pacodey/vishwakarma-2026-haptic-posture-device/photos/makerjourney kicad.png

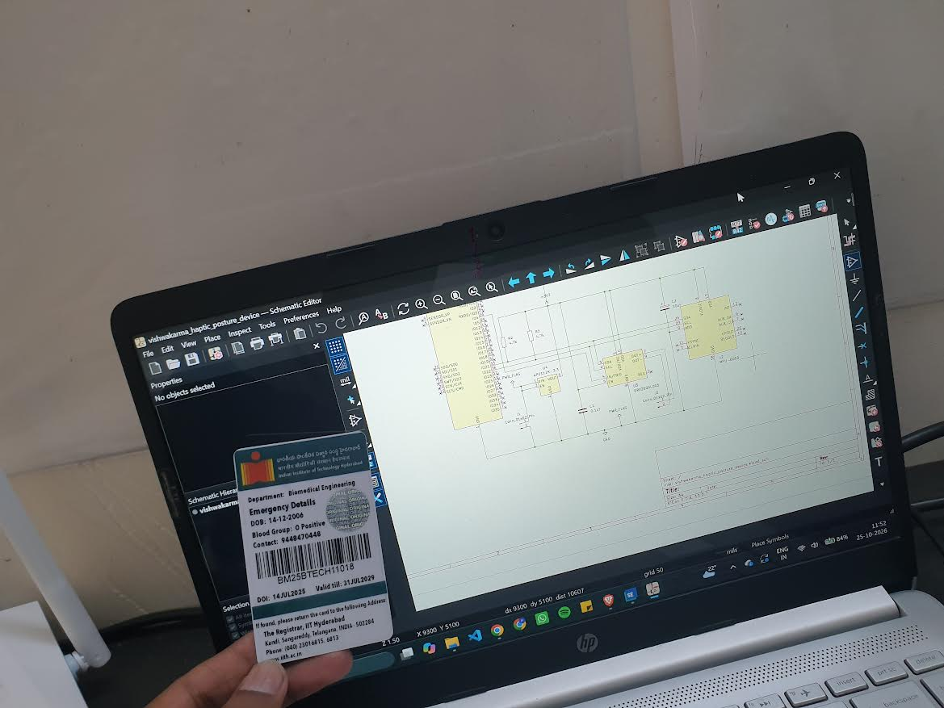
photos/makerjourney kicad.png
