pacodey/vishwakarma-2026-haptic-posture-device/photos/makerjourney materials.jpg

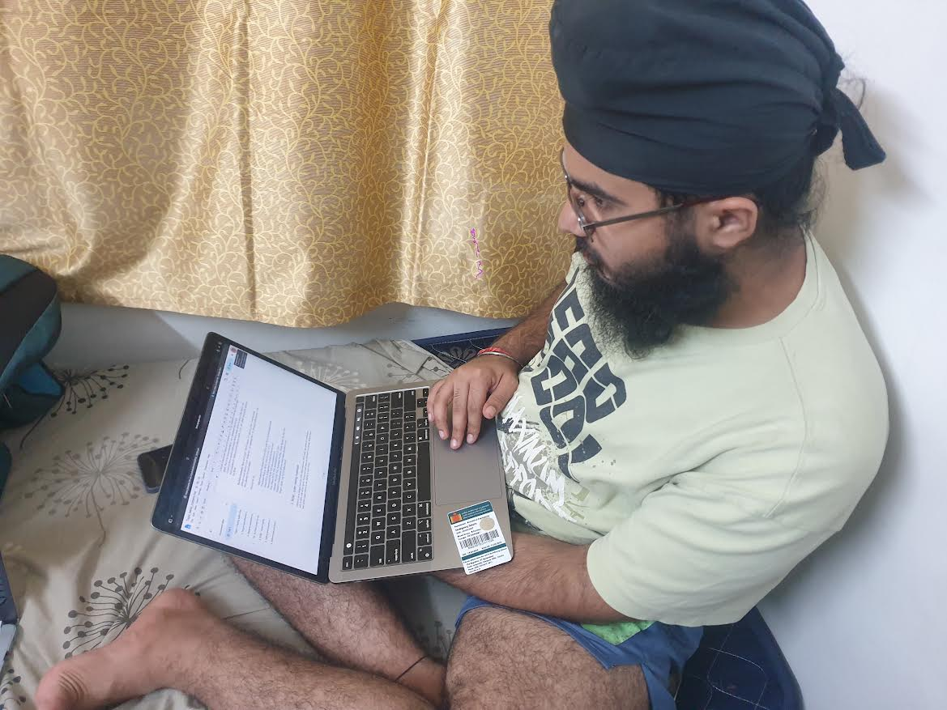
photos/makerjourney materials.jpg
