pacodey/vishwakarma-2026-haptic-posture-device/README.md

# Closed-Loop Haptic Posture Corrector (Posture Pod)

## Project Overview
An ergonomic, sternum-mounted wearable device designed for real-time posture monitoring and active haptic entrainment. Utilizing an ESP32-WROOM-32 MCU and an MPU-6050 6-axis IMU, the system detects thoracic flexion/extension deviations and triggers discrete, frequency-tuned haptic cues via a TI DRV2605L driver and ERM coin motor.
