pacodey/vishwakarma-2026-haptic-posture-device/hardware/README.md

# Electronics Hardware & EDA Files

This folder contains the complete circuit schematics, board layouts, and procurement documentations for the Posture Pod carrier board, built using **KiCad 10.0**.
