pacodey/vishwakarma-2026-haptic-posture-device/CAD/README.md

# Mechanical Design & CAD Assets

This folder contains all parametric 3D CAD assets for the Posture Pod sternum enclosure and internal component stack, developed in **Solid Edge 2026**.
