pacodey/vishwakarma-2026-haptic-posture-device/hardware/posture_respiratory_haptic_block_diagram.pdf

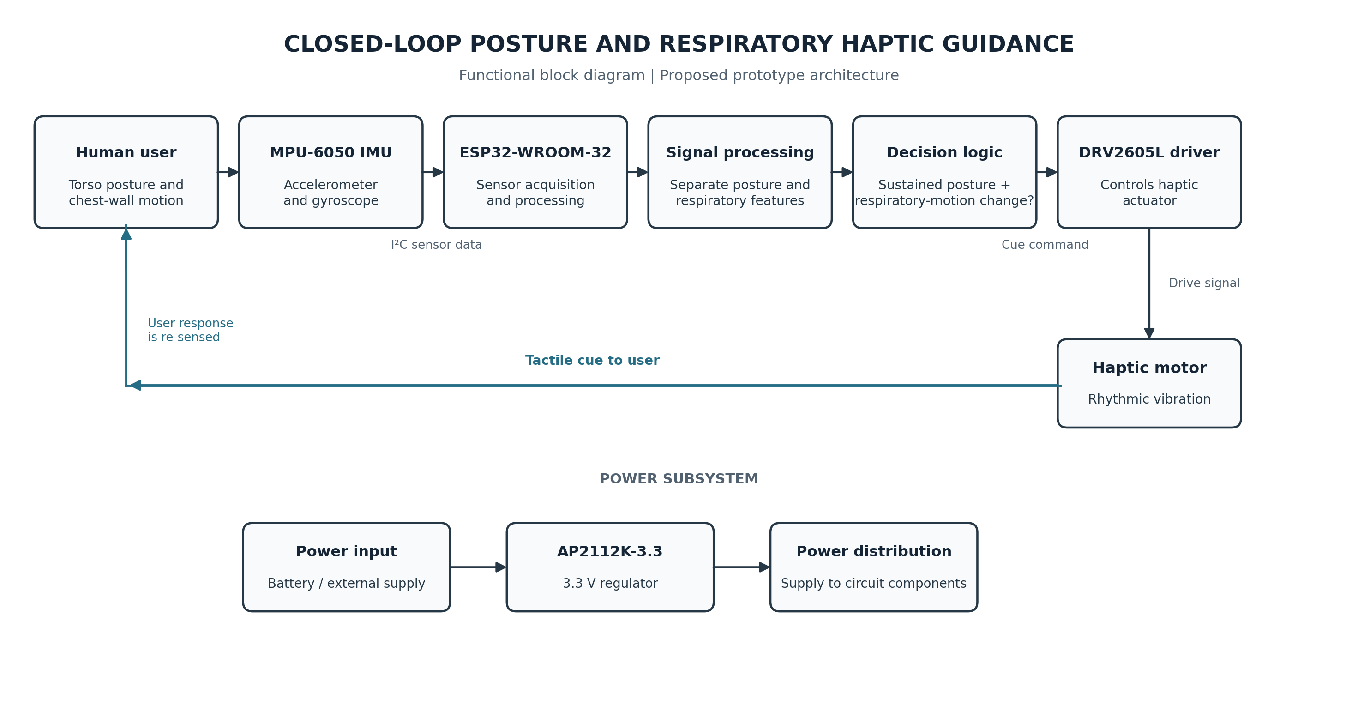
[picture p3: page 1]
