pacodey/vishwakarma-2026-haptic-posture-device/CAD/Exploded_View_Labelled.png

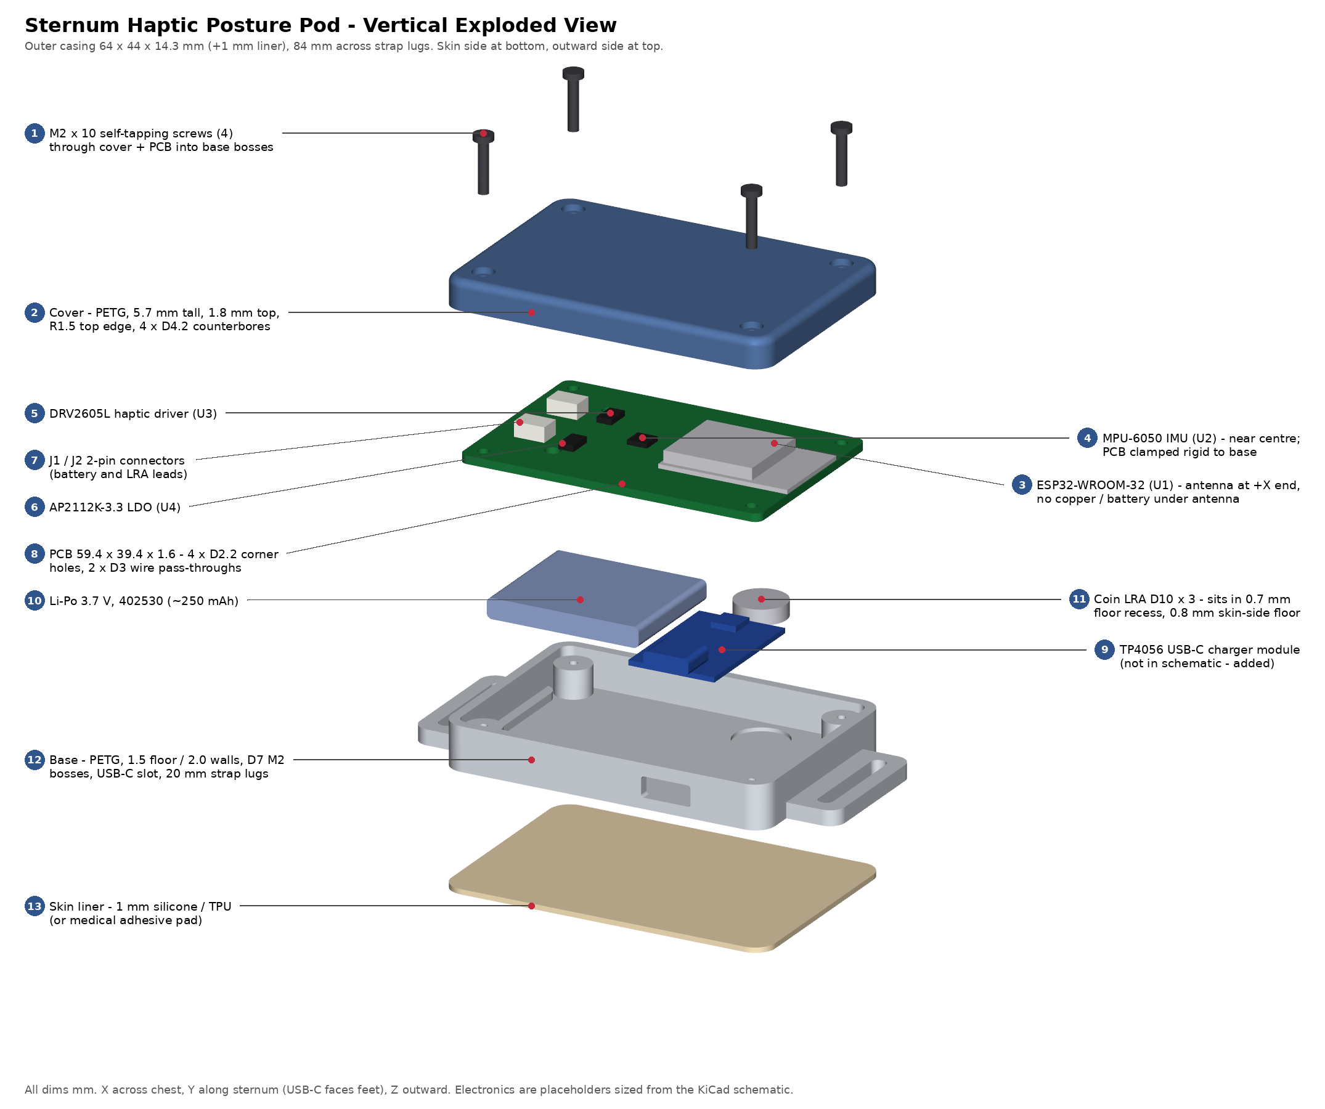
CAD/Exploded_View_Labelled.png
