pacodey/vishwakarma-2026-haptic-posture-device/photos/image.png

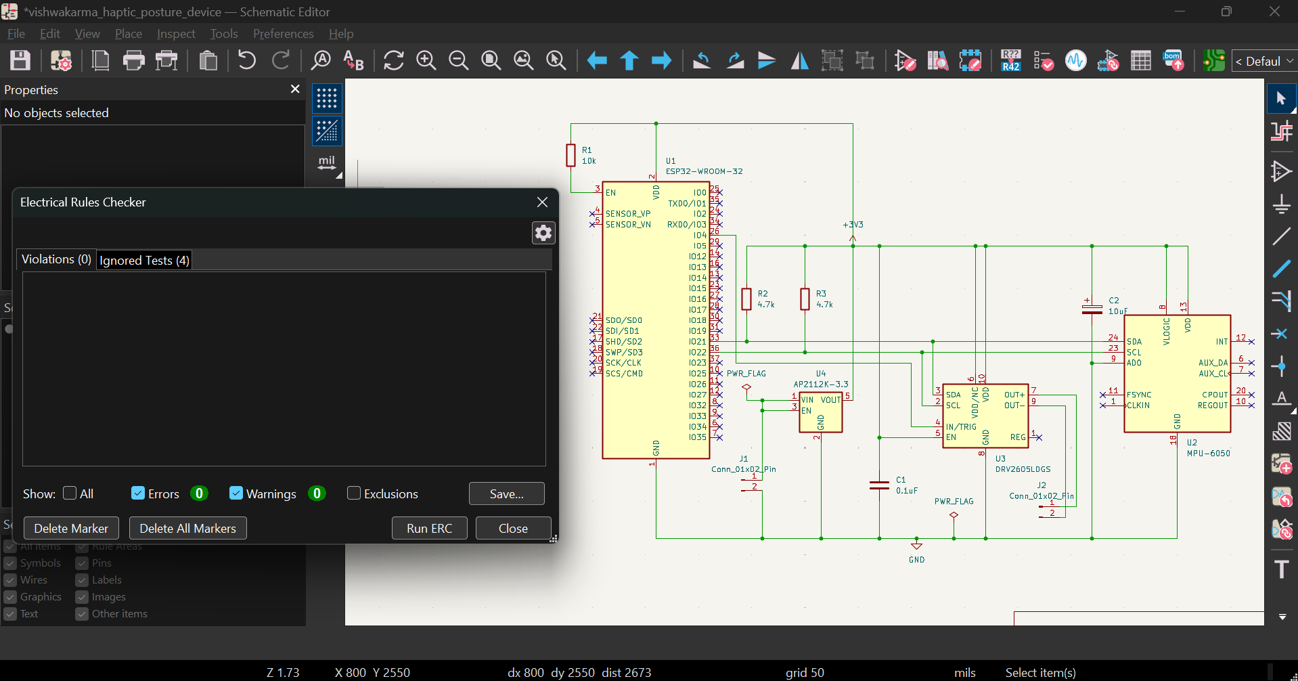
photos/image.png
