pacodey/vishwakarma-2026-haptic-posture-device/photos/kicad schematic.png

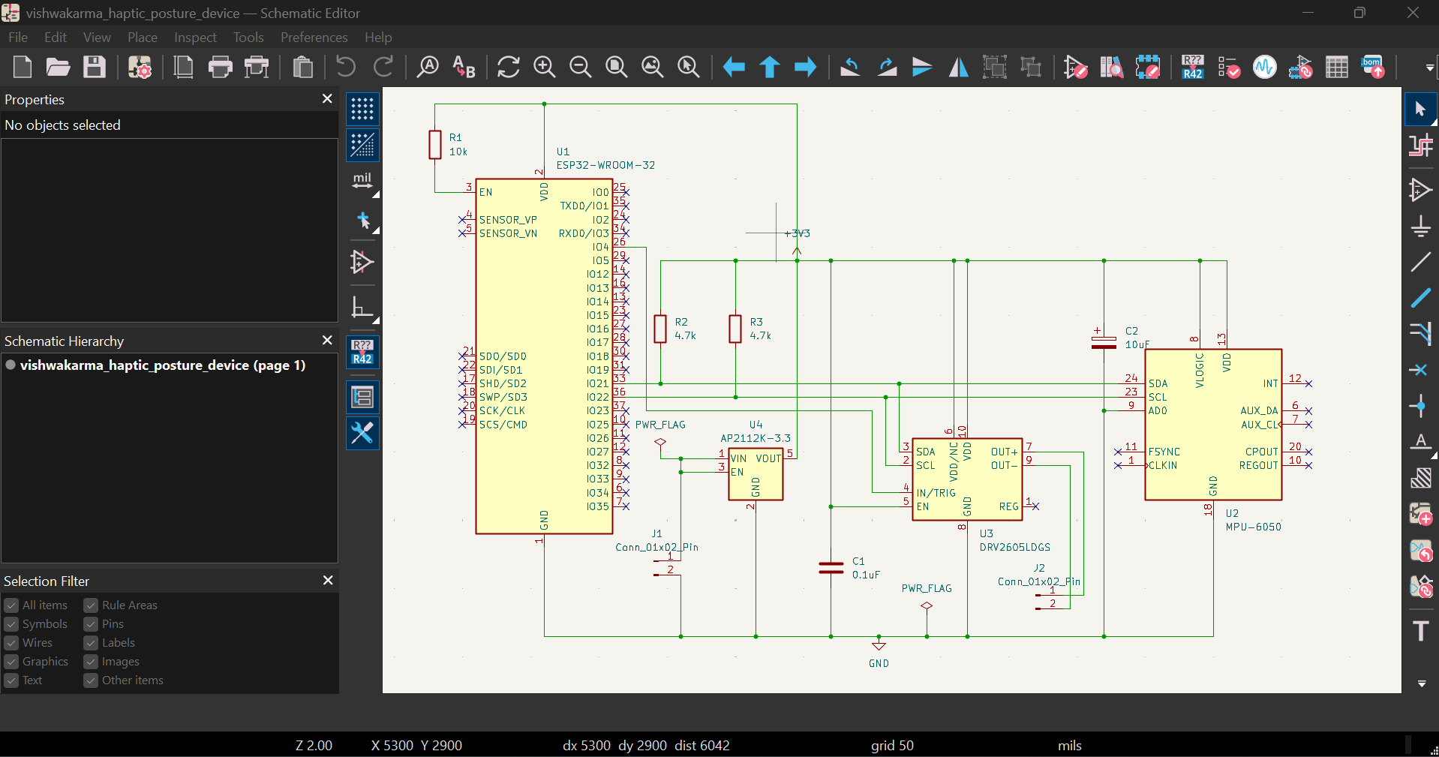
photos/kicad schematic.png
