pacodey/vishwakarma-2026-haptic-posture-device/photos/part2_cover_ss.jpg

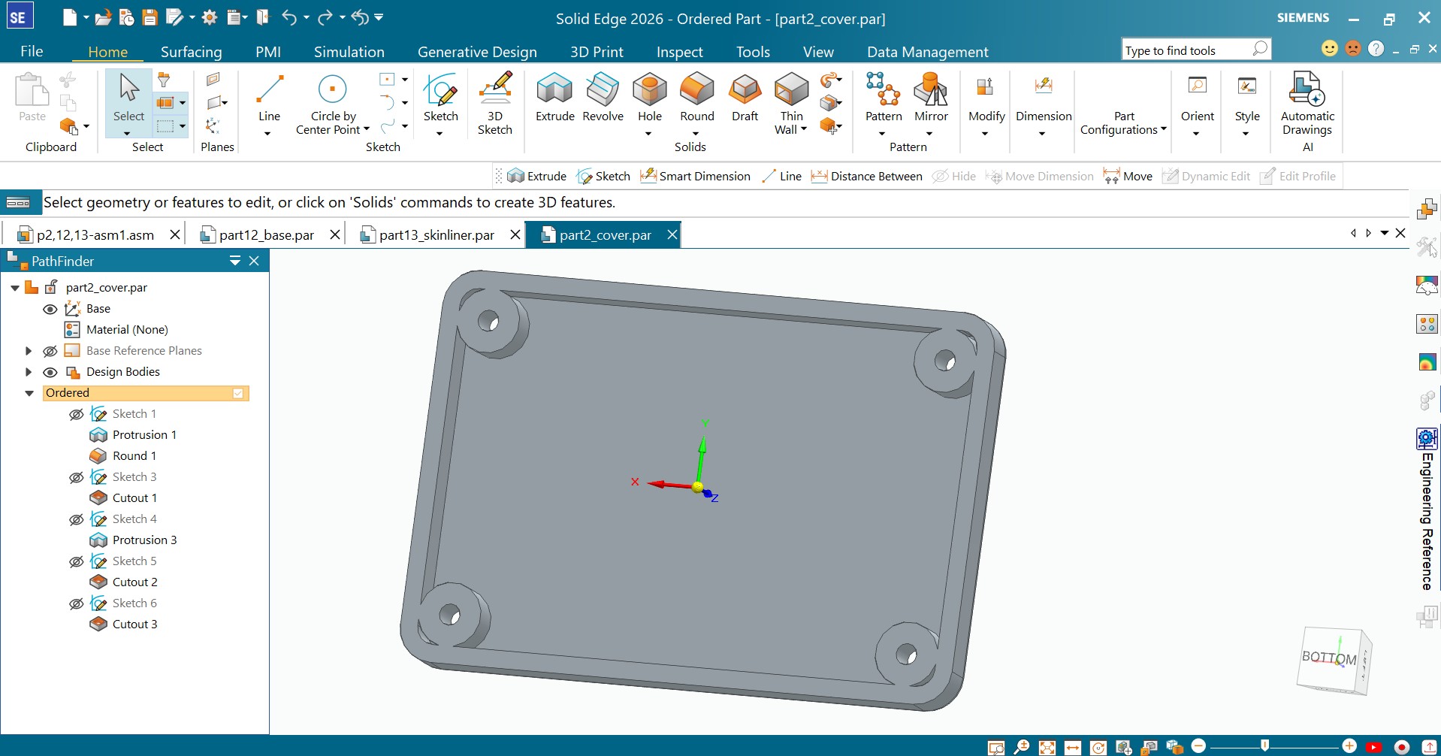
photos/part2_cover_ss.jpg
