pacodey/vishwakarma-2026-haptic-posture-device/photos/part12_base_ss.jpg

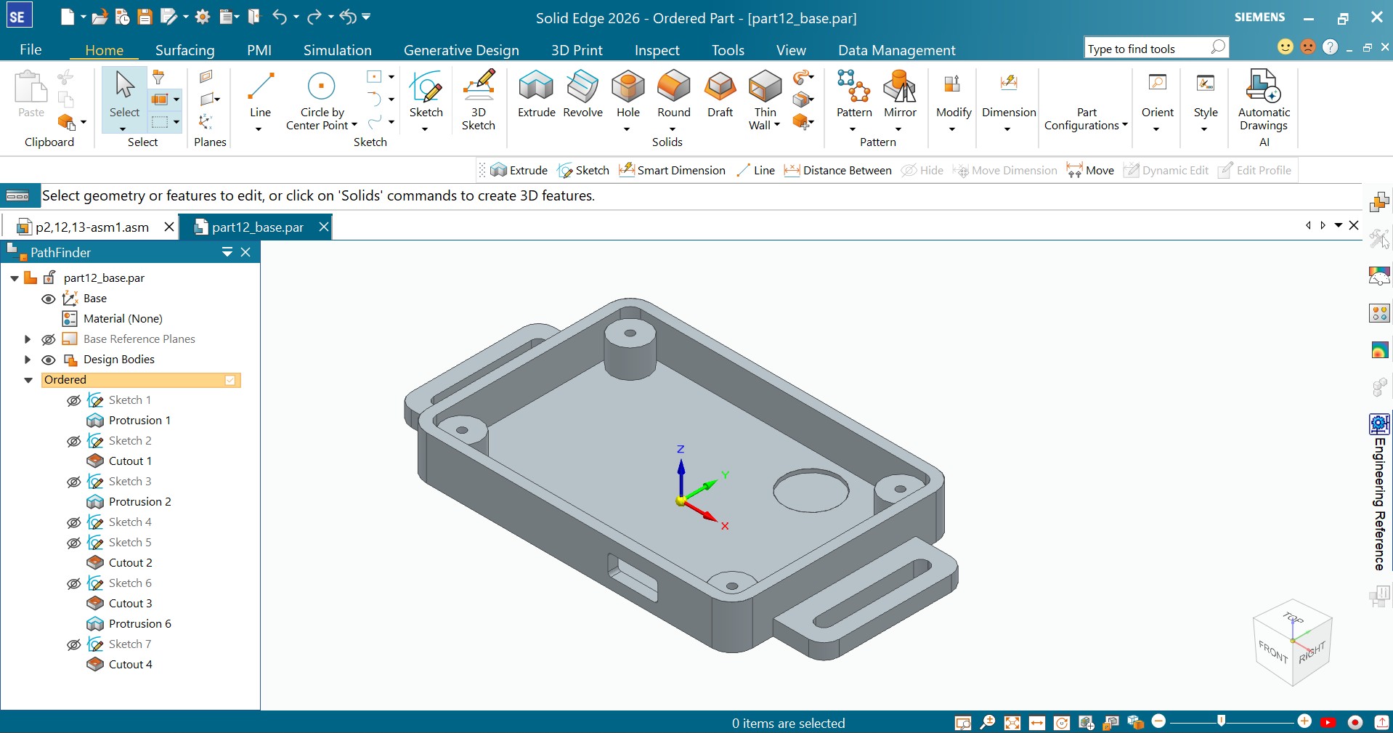
photos/part12_base_ss.jpg
