pacodey/vishwakarma-2026-haptic-posture-device/photos/part13_skinliner_ss.jpg

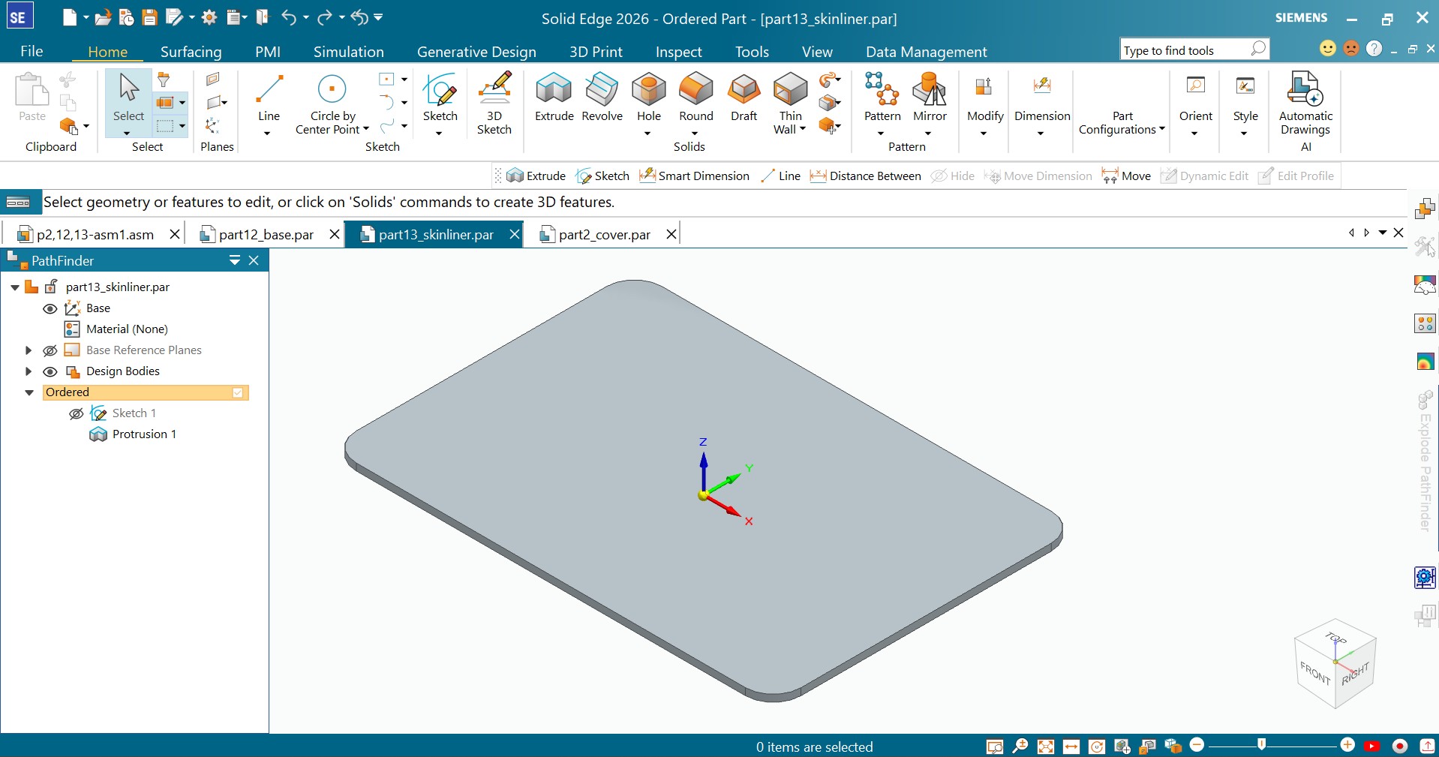
photos/part13_skinliner_ss.jpg
