pacodey/vishwakarma-2026-haptic-posture-device/haptic posture device materials.docx

# Tisjot - Casing tasks (Sternum Haptic Posture Pod)

## 1. Target specification (power, vibration, mechanical)

Parameter | Target | Basis
Outer size | 64 x 44 x 14.3 mm; 15.3 mm with 1 mm liner; 84 mm over strap lugs | Reconstruction sheets, checked on the STEP
Strap | 20 mm webbing through 3 x 22 mm slots | Sheet, Part 12
Pod mass (est.) | about 38 g: casing about 23.6 g (solid PETG + liner), electronics about 14 g | Computed from CAD volumes; the electronics figure is an estimate. Weigh the real build.
Supply | 3.7 V LiPo 402530, about 250 mAh, regulated to 3.3 V (AP2112K-3.3, 600 mA) | Schematic and BOM
Average current for 8 h wear | at most 25 mA (250 mAh x 80% usable / 8 h) | Calculation
Current at about 40 mA average | about 5 h runtime | Calculation
Haptic drive | Drive the LRA at its own resonance. Coin LRAs of this size are typically around 170-240 Hz [verify on your exact part]. | DRV2605L has auto-resonance tracking
Vibration strength | Clearly felt through a shirt on the sternum. Target at least 1 g on the pod, to be confirmed by bench test with a phone accelerometer or the MPU-6050. | Target only, not measured
Charging current | at most 1C = 250 mA (see the safety item on Rprog) | TP4056 datasheet: I = 1200 / Rprog
Skin-side surface temperature | at most 41 degC during charge and use | Conservative target for prolonged skin contact [verify against IEC 62368-1 / IEC 60601-1 limits]
Ingress | No IP claim. Make it IP22 "splash/sweat resistant" only after adding a gasket and testing. | The USB-C slot and the cover seam are unsealed today

Design note: the ESP32-WROOM-32 draws far more than a 25 mA average if Wi-Fi is on. Use BLE only with light sleep, and sample the IMU at 25-50 Hz. Ask Parth to confirm this in firmware.

## 2. Material selection (outer casing)

Part | Chosen | Why | Alternatives considered
Base (12) and Cover (2) | PETG, 3D printed, 4 perimeters | Tough, slightly flexible, so it does not crack at the screw bosses. Easy to print, no supports. Moisture and sweat resistant. Glass transition about 80 degC (verified on several filament datasheets, see section 2A), well above skin and charging temperatures. | PLA: brittle and softens in a hot car. ABS/ASA: fumes and warping, no benefit at this size. Nylon: absorbs moisture. PC: hard to print.
Skin liner (13) | Medical-grade platinum-cured silicone sheet, 1 mm, ISO 10993 / USP Class VI (do not use printed TPU on skin, see 2A) | Soft, grippy and non-irritating. It keeps skin off the printed PETG layer lines. | Direct PETG on skin: layer lines hold sweat and bacteria, and the surface is hard.
Fasteners (1) | 4 x M2 x 10, A2 stainless, button/pan head (ISO 7380 style) | The counterbore is sized for a head 1.1 mm tall. Thread-forming into D1.6 pilots. | Heat-set inserts: better for repeated opening, but more cost and process.
Adhesives | Silicone adhesive or double-sided medical tape (liner); foam tape (LiPo, TP4056) | From the sheet's assembly order | -

Mechanical risk to mention on the slide: the cover top is 1.8 mm and the counterbore is 1.2 mm deep, so only 0.6 mm of PETG sits under each screw head. That is fine for a light-clamp load. If a cover cracks during printing or assembly, make the counterbore 0.8 mm deep (leaving 1.0 mm) and use a lower-head screw.

## 2A. Verified material data

PETG (base and cover)

Property | Verified value | Source datasheet
Density | 1.25-1.29 g/cm3; 1.27 used (matches Fillamentum, Push Plastic, MatterHackers PRO, Kimya 1.274) | ISO 1183 / ASTM D792 values
Glass transition | 80-81 degC | Polymaker PolyLite PETG, Kimya PETG-S, MatterHackers
Heat deflection / Vicat | HDT 0.45 MPa about 75-78 degC; Vicat 84 degC | Polymaker, MatterHackers ESD PETG
Tensile strength, printed XY | 32-47 MPa depending on brand (Polymaker 31.9, Kimya 46.6) | Printed 100% infill specimens
Tensile strength, across layers (Z) | only about 13 MPa | Polymaker PolyLite PETG (Conrad copy)
Water absorption | 0.12-0.54% depending on test | 3D4MAKERS, Polymaker
Compliance claims (vendor claims, not tests you ran) | Kimya PETG-S: RoHS and REACH; food-contact certified in natural colour only. Fillamentum: no restricted substances. | Kimya, Fillamentum datasheets

What this changes in your design:

- Use a conservative 30 MPa for printed PETG in any slide calculation, not the 50 MPa on the spool box.
- Layer adhesion across Z is weak (about 13 MPa). Printing skin-face down keeps the lugs and bosses loaded along the layers, which is what the sheet's print note already does.
- A body-temperature part sits far below 80 degC, so heat is not a PETG problem.
- If you want a filament with a paper trail for the slide, choose one that publishes a RoHS/REACH statement (for example Kimya PETG-S or Fillamentum PETG) and cite that datasheet. Natural/clear colour only for the food-contact claim, which you do not need anyway.

Skin liner: silicone, not TPU

- The Ultimaker TPU 95A datasheet lists in-vivo and food-contact applications as "not suitable". Printed TPU (density 1.20-1.24 g/cm3, Shore 95A) is therefore fine for a prototype liner, but it is not the right material to claim as skin-safe.
- Medical-grade silicone sheet suppliers (for example ElastaPro) state platinum-cured sheet meets USP Class VI and ISO 10993 (cytotoxicity -5, sensitization and irritation -10) and is made for wearables with long skin exposure. These are supplier claims, so ask for the certificate with your quote.
- Choose a soft sheet (about 40-50 Shore A) in 1.0 mm. ElastaPro lists 30-70 durometer sheet. This is my recommendation, not a datasheet requirement.
- I could not find a verified India-based silicone sheet vendor or price in this search. Ask local suppliers for "platinum-cured silicone sheet, 1 mm, ISO 10993" and put the quote in the BOM.

Decision summary: Base and cover = PETG (about 1.27 g/cm3). Liner = medical-grade platinum-cured silicone 1 mm. Fasteners = A2 stainless M2 x 10. Prototype fallback liner = TPU 95A, labelled "not skin-rated".

Sources for 2A:

- MatterHackers PRO Series PETG and ESD-Safe PETG technical data sheets
- Polymaker PolyLite PETG TDS (V3.0 and V4.0)
- Kimya PETG-S datasheet (via shop3duniverse.com)
- Fillamentum PETG TDS (via polyalkemi.no)
- Push Plastic PETG TDS; 3D4MAKERS PETG TDS
- Ultimaker TPU 95A TDS; Polymaker PolyFlex TPU95; Bambu TPU 95A TDS
- ElastaPro medical-grade silicone sheet pages (elastapro.com)
- Moglix, eSUN 1 kg PETG listing (price)

## 3. BOM - outer casing materials

Volumes come straight from the CAD. Mass assumes 100% solid; real prints at 4 perimeters and 20-40% infill will be lighter. Prices and lead times are left blank on purpose: fill them from real vendor pages

# | Part | Material | Qty | Volume (cm3) | Mass (g, solid) | Make/Buy | Supplier / lead time / INR

12 | Base | PETG | 1 | 9.03 | 11.5 | Make (print) | Filament: eSUN PETG 1 kg, Rs 1,744 incl. GST on Moglix at time of search (listed 'available on request'). About Rs 36 of filament for both PETG parts.
2 | Cover | PETG | 1 | 6.98 | 8.9 | Make (print) | ___
13 | Skin liner | Medical-grade silicone sheet, 1 mm | 1 | 2.80 | 3.2 | Buy sheet, cut to 64 x 44 R4 | ___ (ask supplier for ISO 10993 / USP Class VI certificate)
1 | M2 x 10 screw | A2 stainless | 4 | - | about 0.3 total | Buy | ___
- | Medical tape / silicone adhesive | - | 1 | - | - | Buy | ___
- | Foam tape (LiPo and TP4056) | - | 1 | - | - | Buy | ___
- | Strap, 20 mm webbing | Nylon or elastic | 1 | - | - | Buy | ___

Filament: about 20.4 g of PETG solid, plus the liner. 20.4 g / 1000 g x Rs 1,744 = about Rs 36.

## 4. Safety and hazard mitigation (casing + electronics)

# | Hazard | Cause | Mitigation

1 | LiPo overcharge or overheating, fire | Standard TP4056 modules ship with Rprog = 1.2 kohm, which charges at 1 A. That is 4C for a 250 mAh cell. | Change Rprog to 4.7-5.1 kohm (about 255-235 mA). Use a cell with its own protection circuit (PCM). Prefer a TP4056 module that includes DW01 + FS8205 protection.
2 | Burns or discomfort on skin | Hot cell or regulator against the chest | Surface limit of 41 degC (see spec); 1 mm liner; test charging while powered.
3 | Shock or heat while charging on the body | USB-C cable plugged in while worn | Instruction: do not wear while charging. Ask Parth about wiring the charger STAT pin to an ESP32 GPIO so firmware can block haptics during charge. It is not in the current schematic.
4 | Skin irritation or allergy | Hard printed plastic, adhesive, nickel in screws | Silicone liner. Medical tape rated for skin. Do not let the screws touch skin (they are on the outward side, under the cover).
5 | Sweat or moisture ingress | USB-C slot (9.8 x 4.0 mm) and cover seam are open | No IP claim. Add a thin silicone gasket in a later revision. Tell users to keep the slot dry.
6 | Strap lug or boss fracture | Thin 0.6 mm counterbore floor; lug bars about 3 mm wide | Print at 4 perimeters. Strap pull is a few newtons at most. If you have time, a hand-calc or quick FEA on the lug is a good slide.
7 | Radio performance loss | Body tissue and LiPo near the ESP32 antenna | The CAD keeps the antenna at the +X end with no copper or battery under it. Test BLE range on the body.
8 | Vibration annoys or wakes the user | LRA too strong | Software amplitude levels. DRV2605L has built-in effect libraries.

Standards table (apply the "global regulation" line from your task list):

Area | Standard / rule | Applies to
Skin-contact materials | ISO 10993-1 (biological evaluation); -5 cytotoxicity, -10 irritation and sensitization | Liner and any adhesive. Printed PETG is not certified: use filament supplier data, and keep the liner between PETG and skin.
Battery | IEC 62133-2 (cell safety); UN 38.3 (transport); IS 16046 (Part 2) in India [verify] | LiPo cell. Request test reports from the seller.
Product safety | IEC 62368-1 (electronic equipment) | Whole pod
Radio | Module FCC/CE approvals from Espressif; India WPC equipment type approval (ETA) for 2.4 GHz devices [verify] | ESP32-WROOM-32
Hazardous substances | RoHS (EU 2011/65/EU) and India E-Waste (Management) Rules 2022 | Electronics and screws
Positioning | A wellness / posture-coaching device, not a diagnostic or treatment device. If it claimed to treat or diagnose, medical-device rules would apply (India CDSCO Medical Devices Rules 2017; FDA general wellness policy as a reference) [verify]. | Keep all slide wording on "reminder / coaching".

## 5. References and sources

Datasheets

1. Espressif, ESP32-WROOM-32 datasheet.
2. Texas Instruments, DRV2605L datasheet (haptic driver, SLOS854).
3. InvenSense / TDK, MPU-6050 datasheet.
4. Diodes Inc., AP2112 3.3 V LDO datasheet.
5. NanJing Top Power, TP4056 datasheet (charge current = 1200 / Rprog).

Standards and rules 6. ISO 10993-1:2018, Biological evaluation of medical devices. 7. IEC 62133-2:2017, Safety requirements for portable sealed secondary lithium cells. 8. UN Manual of Tests and Criteria, Section 38.3 (lithium battery transport). 9. IEC 62368-1, Audio/video, information and communication technology equipment safety. 10. Directive 2011/65/EU (RoHS); India E-Waste (Management) Rules, 2022. 11. ISO 7380-1 (button head screws). 12. India Medical Devices Rules, 2017 (CDSCO); FDA General Wellness guidance.
