pacodey/vishwakarma-2026-haptic-posture-device/hardware/haptic posture device electronics BOM.pdf

# Itemized Electronics Bill of Materials (BOM)

### Closed-Loop Haptic Posture Corrector (Posture Pod)

ELECTRONICS & SUBSYSTEM BOM

ITEM

COMPONENT
DESCRIPTION

PART NUMBER /
SPECIFICATION

QTY SOURCE / VENDOR

LEAD
TIME

UNIT
COST (₹)

TOTAL (₹)

E1

Microcontroller
Module

ESP32-WROOM-32 (Dual-Core 240MHz)

1 Robu.in / Domestic

2-3
Days
350.00 | 350.00

E2

6-Axis IMU Motion
Sensor

TDK InvenSense MPU-6050 (I2C)

1 | Robu.in / Domestic | 2 Days | 180.00 | 180.00
E3 | Haptic Driver IC

TI DRV2605LDGS (VSSOP-10)

1 | ElectronicsComp | 3 Days | 220.00 | 220.00

E4

Eccentric Mass
Motor

1027 ERM Coin Vibration
Motor (3V)
1 | Local Sourcing | 1 Day | 30.00 | 30.00

E5

Low Dropout
Regulator

AP2112K-3.3V LDO (SOT-23-5)

1 | Robu.in / Domestic | 2 Days | 25.00 | 25.00

E6

Rechargeable
Power Cell

3.7V 500mAh LiPo Cell +
JST-PH2.0
1 | Robu.in / Domestic | 2 Days | 210.00 | 210.00

E7

Battery Charger
Module

TP4056 USB-C Protection
Board
1 | Local Sourcing | 1 Day | 35.00 | 35.00

E8

Passive
Components Set

0805 SMD Resistors,
Caps, J1 Switch

1
Set
Local Sourcing | 1 Day | 32.00 | 32.00
E9 | Custom Carrier PCB

FR4 2-Layer 1.6mm 1oz
Cu (JLCPCB)

1

JLCPCB Domestic
Batch
5 Days | 300.00 | 300.00
TOTAL ELECTRONICS BOM COST: | ₹1,382.00
Closed-Loop Haptic Posture Corrector — Electronics BOM | Page 1 of 1
