pacodey/vishwakarma-2026-haptic-posture-device/CAD/p2,12,13-asm1.stp

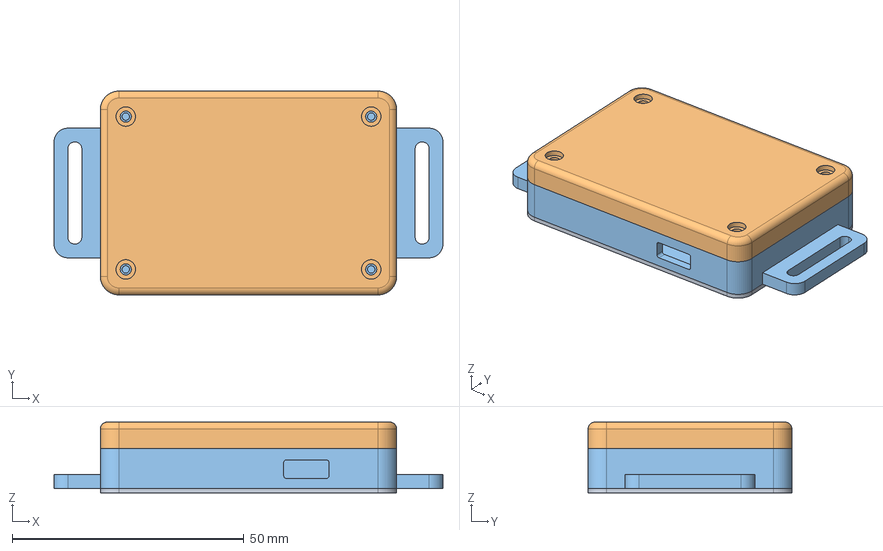
[picture p10: CAD file, 2026-10-25]
CAD/p2,12,13-asm1.stp
84.0 x 44.0 x 15.3 mm
part13_skinliner
part2_cover
part12_base
