pacodey/vishwakarma-2026-haptic-posture-device/CAD/part13_skinliner.stp

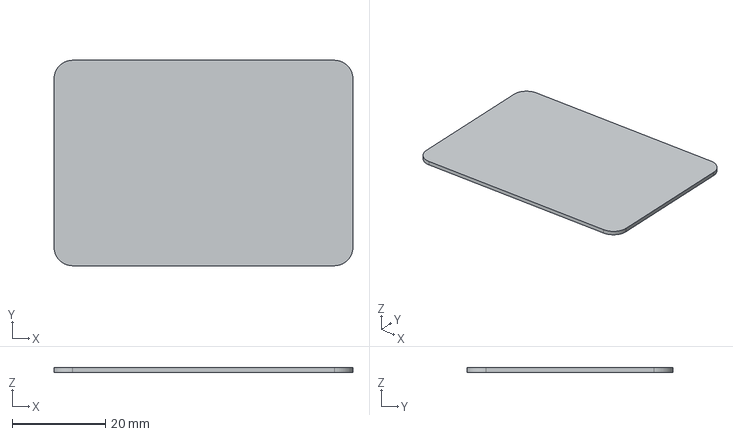
[picture p11: CAD file, 2026-10-25]
CAD/part13_skinliner.stp
64.0 x 44.0 x 1.00 mm
