pacodey/vishwakarma-2026-haptic-posture-device/CAD/part2_cover.stp

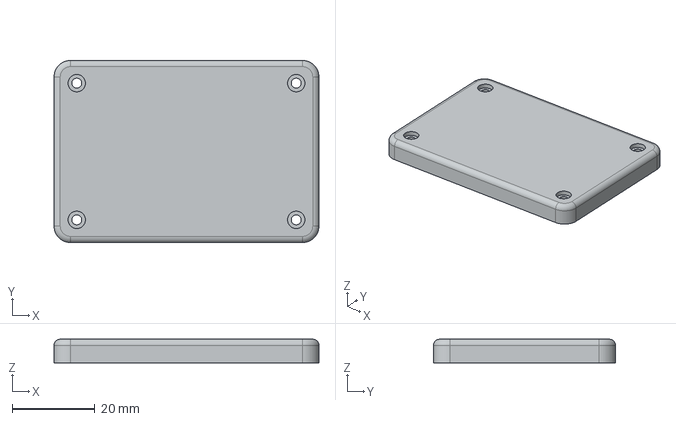
[picture p12: CAD file, 2026-10-25]
CAD/part2_cover.stp
64.0 x 44.0 x 5.70 mm
