pacodey/vishwakarma-2026-haptic-posture-device/CAD/part12_base.stp

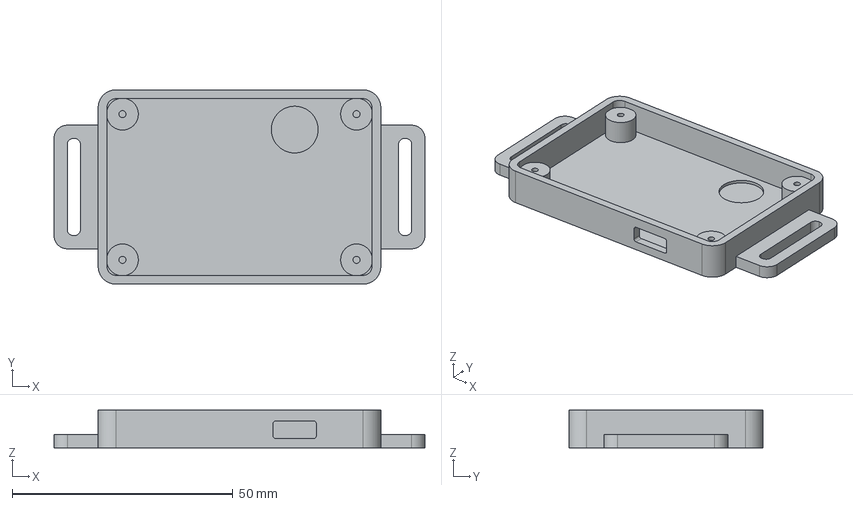
[picture p13: CAD file, 2026-10-25]
CAD/part12_base.stp
84.0 x 44.0 x 8.60 mm
