pacodey/vishwakarma-2026-haptic-posture-device/hardware/vishwakarma_haptic_posture_device.pdf

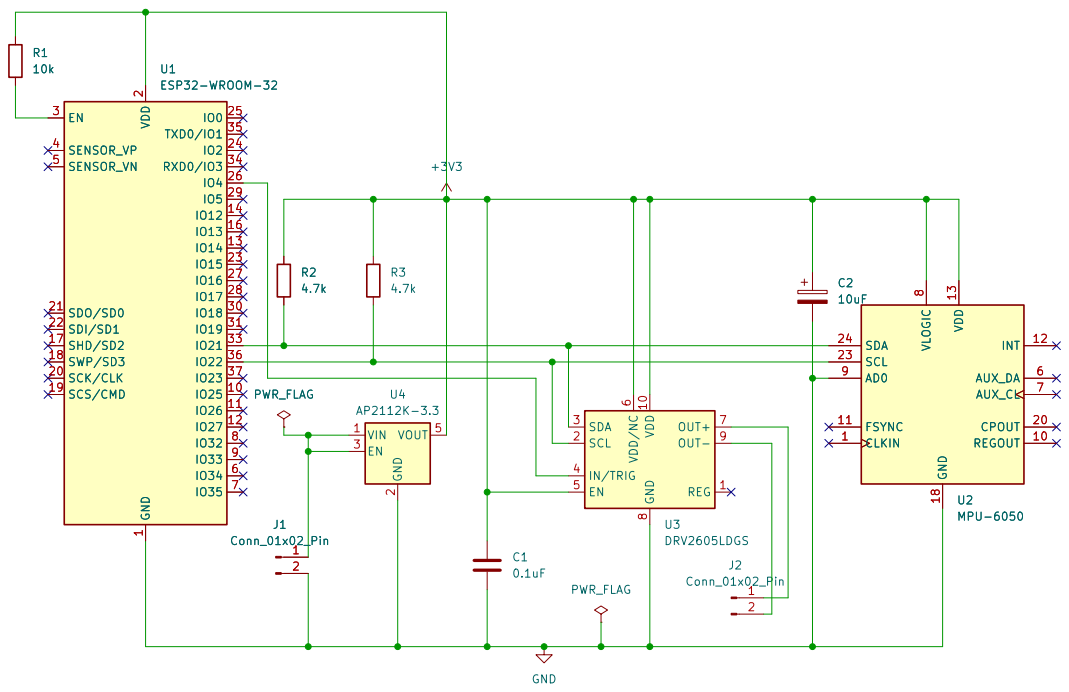
[picture p14: page 1]

Size: A4 | Rev:
KiCad E.D.A. 10.0.7 | Id: 1/1
