pacodey/vishwakarma-2026-haptic-posture-device/hardware/vishwakarma_haptic_posture_device.kicad_sch

## KiCad design hardware/vishwakarma_haptic_posture_device.kicad_sch (2026-10-21)

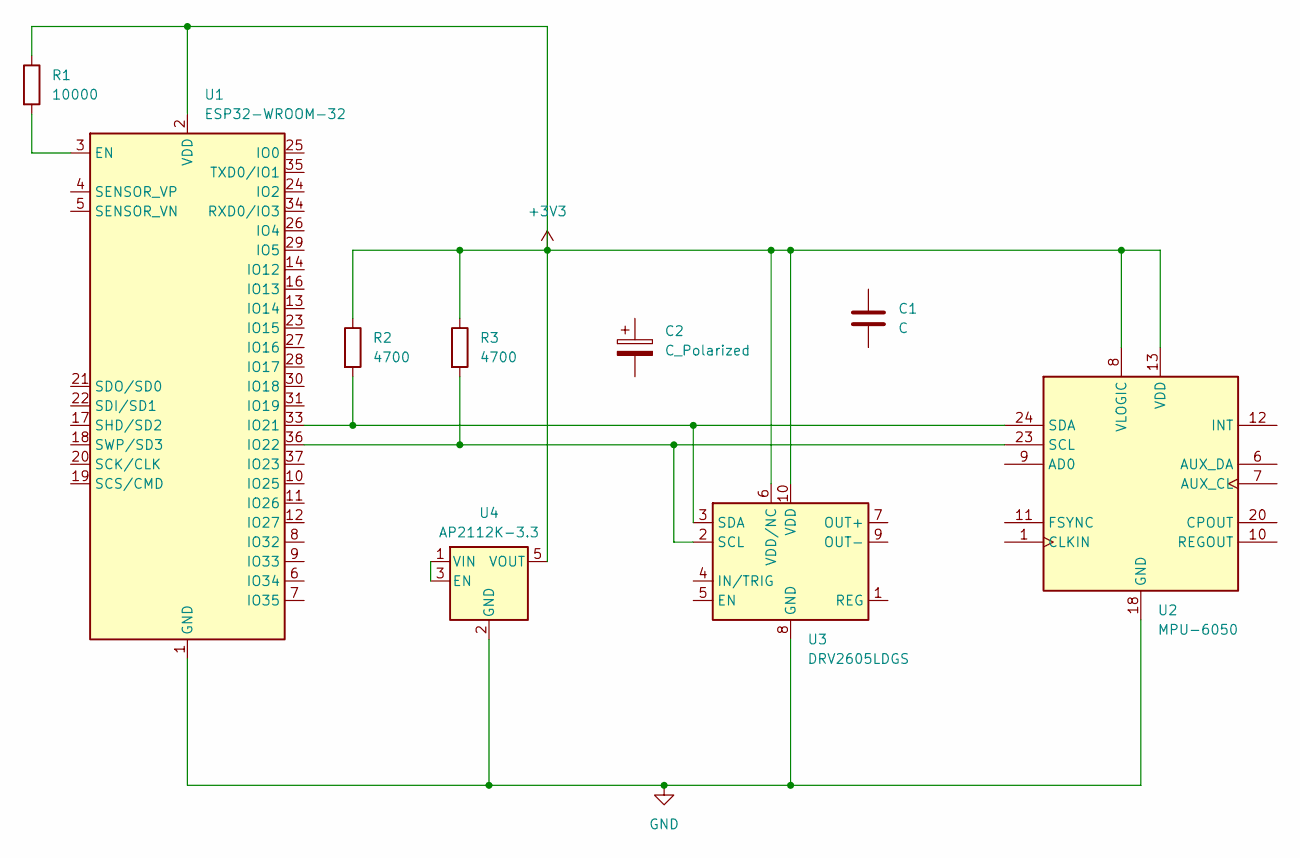
[picture p15: schematic vishwakarma_haptic_posture_device.kicad_sch]

Parts:
C1: C
C2: C_Polarized
R1: 10000
R2, R3: 4700
U1: ESP32-WROOM-32
U2: MPU-6050; InvenSense_QFN-24_4x4mm_P0.5mm
U3: DRV2605LDGS; TSSOP-10_3x3mm_P0.5mm
U4: AP2112K-3.3; SOT-23-5

Connections:
+3V3: R1.1, R2.1, R3.1, U1.2 (VDD), U2.8 (VLOGIC), U2.13 (VDD), U3.6 (VDD/NC), U3.10 (VDD), U4.5 (VOUT)
GND: U1.1 (GND), U1.15 (GND), U1.38 (GND), U1.39 (GND), U2.18 (GND), U3.8 (GND), U4.2 (GND)
unnamed: R1.2, U1.3 (EN)
unnamed: R2.2, U1.33 (IO21), U2.24 (SDA), U3.3 (SDA)
unnamed: R3.2, U1.36 (IO22), U2.23 (SCL), U3.2 (SCL)
unnamed: U4.1 (VIN), U4.3 (EN)
