pacodey/vishwakarma-2026-haptic-posture-device/CAD/assembly_exploded.jpg

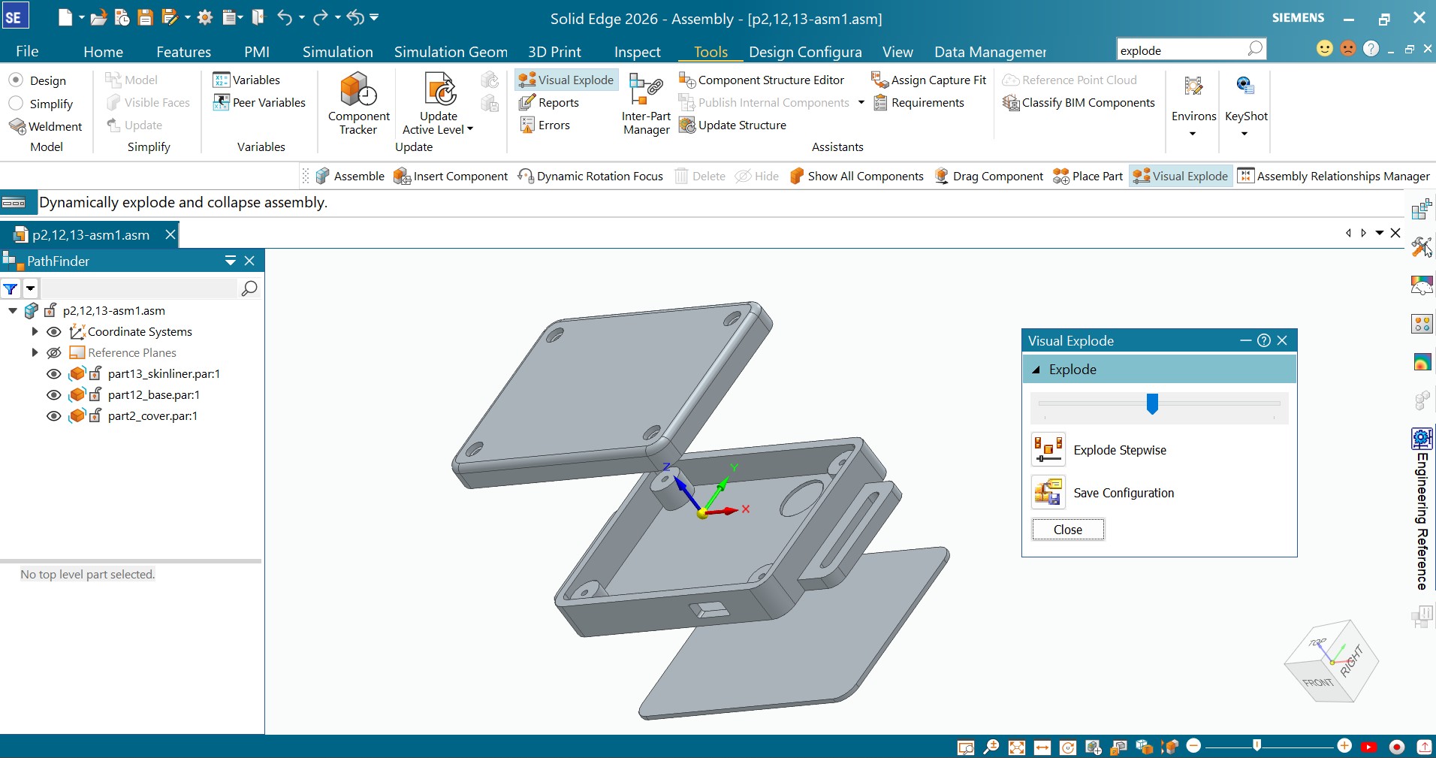
CAD/assembly_exploded.jpg
