pacodey/vishwakarma-2026-haptic-posture-device/photos/assembly_ss.jpg

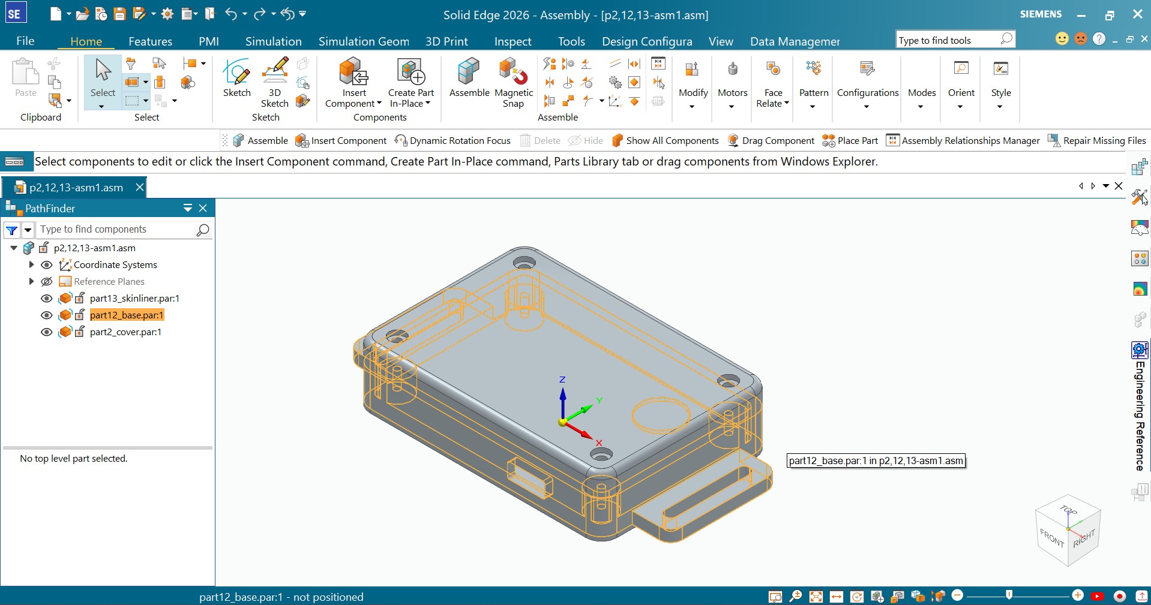
photos/assembly_ss.jpg
