pacodey/vishwakarma-2026-haptic-posture-device/photos/makerjourney cad.png

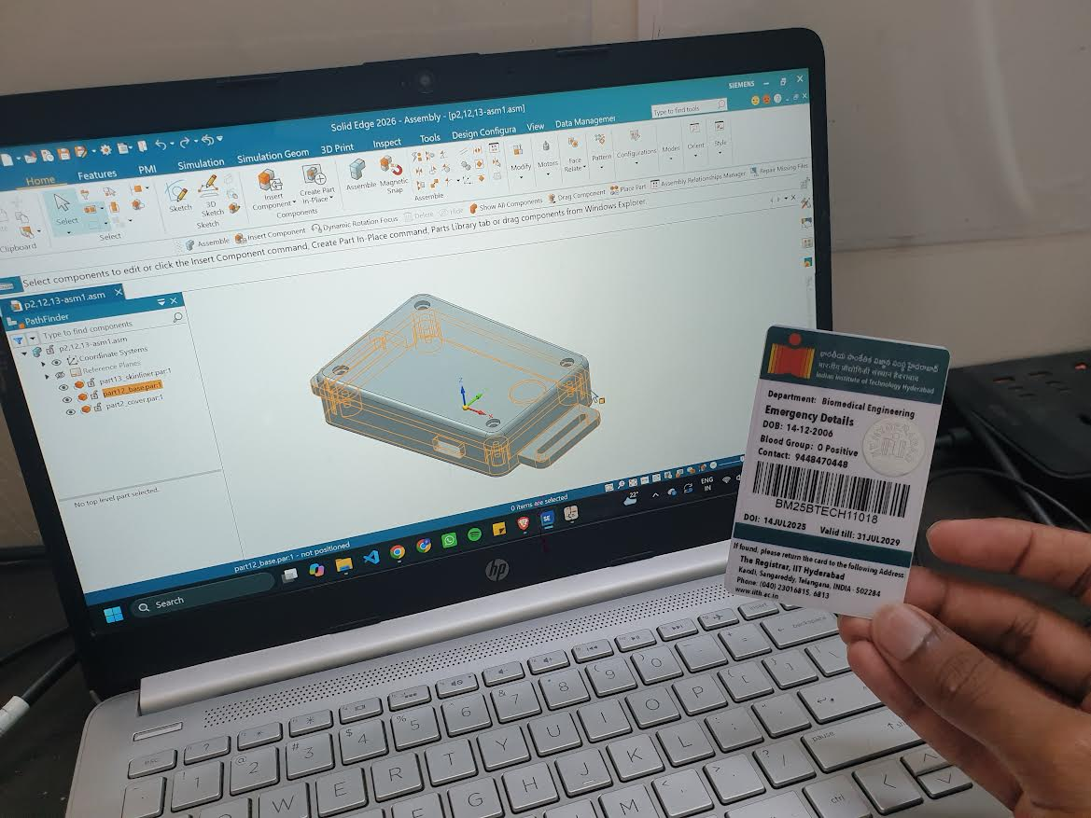
photos/makerjourney cad.png
