pacodey/vishwakarma-2026-haptic-posture-device/(commit log)

2026-10-21 schematic design kicad screenshot (0 ERC errors)
2026-10-21 added exported schematic design pdf
2026-10-21 added kicad schematic file
    [vishwakarma_haptic_posture_device.kicad_sch]
2026-10-23 uploaded kicad schematic screenshot
2026-10-25 uploaded CAD STEP files
    [p2,12,13-asm1.stp, part12_base.stp, part13_skinliner.stp, part2_cover.stp]
2026-10-25 uploaded solid edge part and assembly files
2026-10-25 uploaded CAD solid edge screenshots
2026-10-25 uploaded electronics BOM
2026-10-25 uploaded materials file
2026-10-25 uploaded makerjourney materials
